Galacs/mhadb-line-sensor/mhadb-line-sensor.kicad_pcb

## KiCad design mhadb-line-sensor.kicad_pcb (2026-01-11)

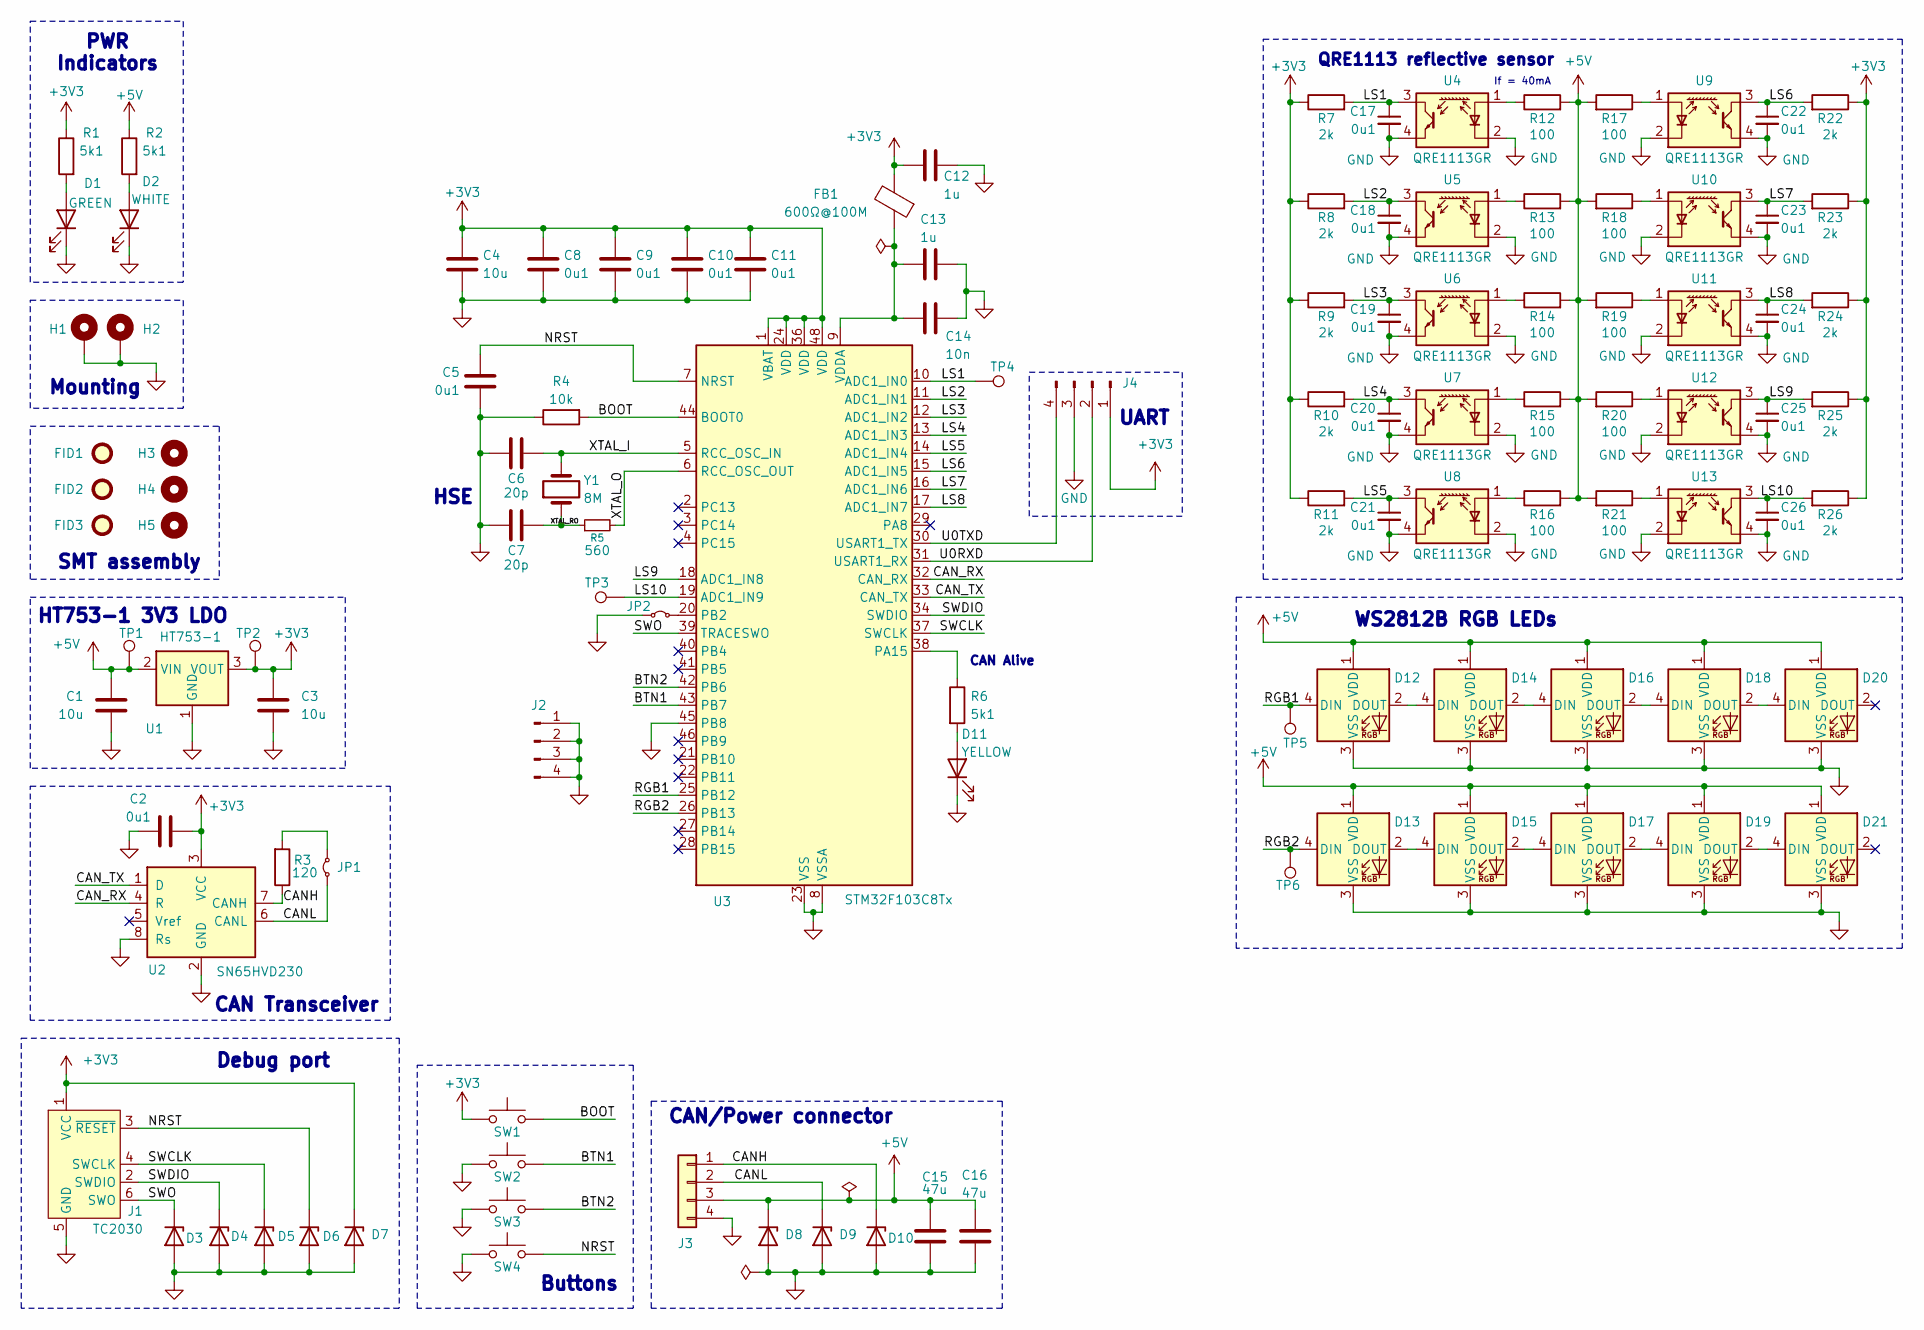
[picture p1: schematic mhadb-line-sensor.kicad_sch, MHADB Line sensor]

Parts:
C1, C3, C4: 10u; C_0805_2012Metric; Manufacturer Part Number GRM21BR61H106KE43L; JLCPCB Part # C440198
C2, C5, C8, C9, C10, C11, C17, C18, C19, C20, C21, C22, C23, C24, C25, C26: 0u1; C_0402_1005Metric; Manufacturer Part Number CL05B104KB54PNC; JLCPCB Part # C307331
C6, C7: 20p; C_0603_1608Metric; Manufacturer Part Number CL10C200JB8NNNC; JLCPCB Part # C1648
C12, C13: 1u; C_0402_1005Metric; Manufacturer Part Number CL05A105KA5NQNC; JLCPCB Part # C52923
C14: 10n; C_0402_1005Metric; Manufacturer Part Number CL05B103KB5NNNC; JLCPCB Part # C15195
C15, C16: 47u; C_1206_3216Metric; Manufacturer Part Number CL31A476MPHNNNE; JLCPCB Part # C96123
D1: GREEN; LED_0805_2012Metric; Manufacturer Part Number KT-0805G; JLCPCB Part # C2297
D2: WHITE; LED_0603_1608Metric; Manufacturer Part Number KT-0603W; JLCPCB Part # C2290
D3, D4, D5, D6, D7, D8, D9, D10: H5VU10U; Diode_DFN1006; Manufacturer Part Number H5VU10U; JLCPCB Part # C22395519
D11: YELLOW; LED_0805_2012Metric; Manufacturer Part Number KT-0805Y; JLCPCB Part # C2296
D12, D13, D14, D15, D16, D17, D18, D19, D20, D21: WS2812B; LED_WS2812B_PLCC4_5.0x5.0mm_P3.2mm; Manufacturer Part Number WS2812B-V5/W; JLCPCB Part # C2874885
FB1: 600Ω@100M; L_0805_2012Metric; Manufacturer Part Number MPZ2012S601ATD25; JLCPCB Part # C81034
FID1, FID2, FID3: Fiducial; Fiducial_1mm_Mask2mm
H1, H2: MountingHole_Pad; MountingHole_2.2mm_M2_Pad_Via
H3, H4, H5: MountingHole; ToolingHole_1.152mm
J1: TC2030; Tag-Connect_TC2030-IDC-NL_2x03_P1.27mm_Vertical
J2, J4: Conn_01x04_Pin; PinHeader_1x04_P2.54mm_Vertical
J3: Conn_01x04; JST_PH_S4B-PH-K_1x04_P2.00mm_Horizontal; Manufacturer Part Number S4B-PH-K-S(LF)(SN); JLCPCB Part # C157926
JP1: Jumper_2_Small_Bridged; SolderJumper-2_P1.3mm_Open_RoundedPad1.0x1.5mm
JP2: Jumper_2_Small_Bridged; SolderJumper-2_P1.3mm_Bridged_RoundedPad1.0x1.5mm
R1, R2, R6: 5k1; R_0402_1005Metric; Manufacturer Part Number 0402WGF5101TCE; JLCPCB Part # C25905
R3: 120; R_1206_3216Metric; Manufacturer Part Number 1206W4F1200T5E; JLCPCB Part # C17909
R4: 10k; R_0402_1005Metric; Manufacturer Part Number 0402WGF1002TCE; JLCPCB Part # C25744
R5: 560; R_0603_1608Metric; Manufacturer Part Number 0603WAF5600T5E; JLCPCB Part # C23204
R7, R8, R9, R10, R11, R22, R23, R24, R25, R26: 2k; R_0603_1608Metric; Manufacturer Part Number 0603WAF2201T5E; JLCPCB Part # C4190
R12, R13, R14, R15, R16, R17, R18, R19, R20, R21: 100; R_1206_3216Metric; Manufacturer Part Number 1206W4F1000T5E; JLCPCB Part # C17901
SW1, SW2, SW3, SW4: SW_Push; SW_SPST_TS-1088-xR020; Manufacturer Part Number TS-1088-AR02016; JLCPCB Part # C720477
TP1, TP2, TP3, TP4, TP5, TP6: TestPoint; TestPoint_Pad_D2.0mm
U1: HT753-1; SOT-89-3; Manufacturer Part Number HT7533-1; JLCPCB Part # C14289
U2: SN65HVD230; SOIC-8_3.9x4.9mm_P1.27mm; Manufacturer Part Number SN65HVD230DR; JLCPCB Part # C12084
U3: STM32F103C8Tx; LQFP-48_7x7mm_P0.5mm; Manufacturer Part Number STM32F103C8T6; JLCPCB Part # C8734
U4, U5, U6, U7, U8, U9, U10, U11, U12, U13: QRE1113GR; OnSemi_CASE100CY; Manufacturer Part Number QRE1113GR; JLCPCB Part # C232862
Y1: 8M; Crystal_SMD_5032-2Pin_5.0x3.2mm; Manufacturer Part Number X50328MSB2GI; JLCPCB Part # C115962

Connections:
+3V3: C2.1, C3.1, C4.1, C8.1, C9.1, C10.1, C11.1, C12.1, D7.1 (K), FB1.2, J1.1 (VCC), J4.1, R1.1, R7.1, R8.1, R9.1, R10.1, R11.1, R22.1, R23.1, R24.1, R25.1, R26.1, SW1.1, TP2.1, U1.3 (VOUT), U2.3 (VCC), U3.1 (VBAT), U3.24 (VDD), U3.36 (VDD), U3.48 (VDD)
+5V: C1.1, C15.1, C16.1, D8.1 (K), D12.1 (VDD), D13.1 (VDD), D14.1 (VDD), D15.1 (VDD), D16.1 (VDD), D17.1 (VDD), D18.1 (VDD), D19.1 (VDD), D20.1 (VDD), D21.1 (VDD), J3.3, R2.1, R12.2, R13.2, R14.2, R15.2, R16.2, R17.2, R18.2, R19.2, R20.2, R21.2, TP1.1, U1.2 (VIN)
/BOOT: R4.2, SW1.2, U3.44 (BOOT0)
/BTN1: SW2.2, U3.43 (PB7)
/BTN2: SW3.2, U3.42 (PB6)
/CANH: D10.1 (K), J3.1, R3.1, U2.7 (CANH)
/CANL: D9.1 (K), J3.2, JP1.1 (A), U2.6 (CANL)
/CAN_RX: U2.4 (R), U3.32 (CAN_RX)
/CAN_TX: U2.1 (D), U3.33 (CAN_TX)
/LS1: C17.1, R7.2, TP4.1, U3.10 (ADC1_IN0), U4.3
/LS2: C18.1, R8.2, U3.11 (ADC1_IN1), U5.3
/LS3: C19.1, R9.2, U3.12 (ADC1_IN2), U6.3
/LS4: C20.1, R10.2, U3.13 (ADC1_IN3), U7.3
/LS5: C21.1, R11.2, U3.14 (ADC1_IN4), U8.3
/LS6: C22.1, R22.2, U3.15 (ADC1_IN5), U9.3
/LS7: C23.1, R23.2, U3.16 (ADC1_IN6), U10.3
/LS8: C24.1, R24.2, U3.17 (ADC1_IN7), U11.3
/LS9: C25.1, R25.2, U3.18 (ADC1_IN8), U12.3
/LS10: C26.1, R26.2, TP3.1, U3.19 (ADC1_IN9), U13.3
/NRST: C5.1, D6.1 (K), J1.3 (~RESET), SW4.2, U3.7 (NRST)
/RGB1: D12.4 (DIN), TP5.1, U3.25 (PB12)
/RGB2: D13.4 (DIN), TP6.1, U3.26 (PB13)
/SWCLK: D5.1 (K), J1.4 (SWCLK), U3.37 (SWCLK)
/SWDIO: D4.1 (K), J1.2 (SWDIO), U3.34 (SWDIO)
/SWO: D3.1 (K), J1.6 (SWO), U3.39 (TRACESWO)
/U0RXD: J4.2, U3.31 (USART1_RX)
/U0TXD: J4.4, U3.30 (USART1_TX)
/XTAL_I: C6.1, U3.5 (RCC_OSC_IN), Y1.2
/XTAL_O: R5.2, U3.6 (RCC_OSC_OUT)
/XTAL_RO: C7.1, R5.1, Y1.1
GND: C1.2, C2.2, C3.2, C4.2, C5.2, C6.2, C7.2, C8.2, C9.2, C10.2, C11.2, C12.2, C13.2, C14.2, C15.2, C16.2, C17.2, C18.2, C19.2, C20.2, C21.2, C22.2, C23.2, C24.2, C25.2, C26.2, D1.1 (K), D2.1 (K), D3.2 (A), D4.2 (A), D5.2 (A), D6.2 (A), D7.2 (A), D8.2 (A), D9.2 (A), D10.2 (A), D11.1 (K), D12.3 (VSS), D13.3 (VSS), D14.3 (VSS), D15.3 (VSS), D16.3 (VSS), D17.3 (VSS), D18.3 (VSS), D19.3 (VSS), D20.3 (VSS), D21.3 (VSS), H1.1, H2.1, J1.5 (GND), J2.1, J2.2, J2.3, J2.4, J3.4, J4.3, JP2.1 (A), R4.1, SW2.1, SW3.1, SW4.1, U1.1 (GND), U2.2 (GND), U2.8 (Rs), U3.8 (VSSA), U3.23 (VSS), U3.35 (VSS), U3.45 (PB8), U3.47 (VSS), U4.2 (K), U4.4, U5.2 (K), U5.4, U6.2 (K), U6.4, U7.2 (K), U7.4, U8.2 (K), U8.4, U9.2 (K), U9.4, U10.2 (K), U10.4, U11.2 (K), U11.4, U12.2 (K), U12.4, U13.2 (K), U13.4
unnamed: D1.2 (A), R1.2
unnamed: D2.2 (A), R2.2
unnamed: D11.2 (A), R6.2
unnamed: D12.2 (DOUT), D14.4 (DIN)
unnamed: D13.2 (DOUT), D15.4 (DIN)
unnamed: D14.2 (DOUT), D16.4 (DIN)
unnamed: D15.2 (DOUT), D17.4 (DIN)
unnamed: D16.2 (DOUT), D18.4 (DIN)
unnamed: D17.2 (DOUT), D19.4 (DIN)
unnamed: D18.2 (DOUT), D20.4 (DIN)
unnamed: D19.2 (DOUT), D21.4 (DIN)
unnamed: JP1.2 (B), R3.2
unnamed: JP2.2 (B), U3.20 (PB2)
unnamed: R6.1, U3.38 (PA15)
unnamed: C13.1, C14.1, FB1.1, U3.9 (VDDA)
unnamed: R12.1, U4.1 (A)
unnamed: R13.1, U5.1 (A)
unnamed: R14.1, U6.1 (A)
unnamed: R15.1, U7.1 (A)
unnamed: R16.1, U8.1 (A)
unnamed: R17.1, U9.1 (A)
unnamed: R18.1, U10.1 (A)
unnamed: R19.1, U11.1 (A)
unnamed: R20.1, U12.1 (A)
unnamed: R21.1, U13.1 (A)

Notes on the sheet:
CAN Transceiver
WS2812B RGB LEDs
Buttons
CAN Alive
If = 40mA
UART
PWR Indicators
SMT assembly
QRE1113 reflective sensor
Mounting
HT753-1 3V3 LDO
Debug port
CAN/Power connector
HSE

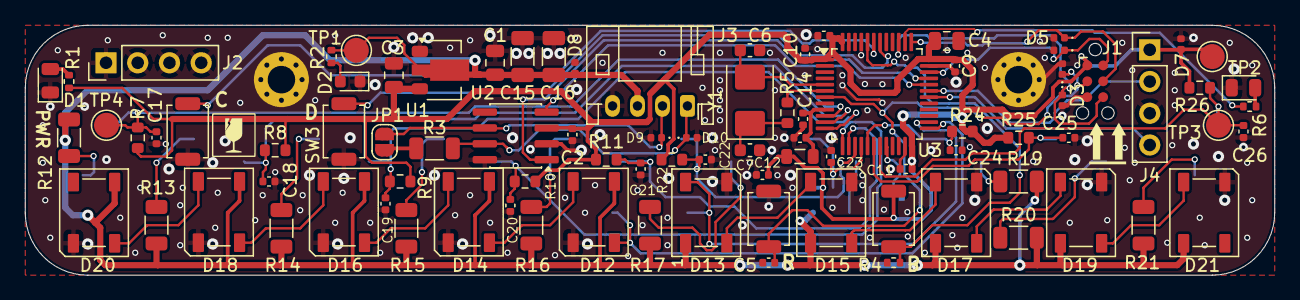
[picture p2: board mhadb-line-sensor.kicad_pcb from above]

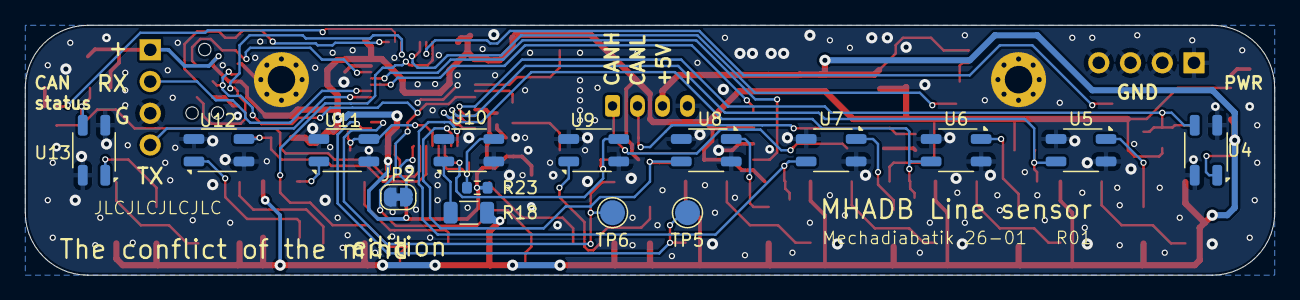
[picture p3: board mhadb-line-sensor.kicad_pcb from below]

Board: 2 copper layers, 100.0 x 20.0 mm, 106 parts (15 on the bottom side), 56 nets.
