Galacs/mhadb-line-sensor/(commit log)

2026-01-08 schem: add STM32F103C8Tx MCU with decoupling
    [mhadb-line-sensor.kicad_pcb, mhadb-line-sensor.kicad_sch]
2026-01-08 schem: import HSE and boot/rst
    [mhadb-line-sensor.kicad_sch]
2026-01-08 schem: add CAN/Power connector
    [mhadb-line-sensor.kicad_sch]
2026-01-08 schem: add TC2030 SWD debug port
    [mhadb-line-sensor.kicad_sch]
2026-01-08 schem: add SN65HVD230 CAN transceiver
    [mhadb-line-sensor.kicad_sch]
2026-01-08 schem: add UART1 header
    [mhadb-line-sensor.kicad_sch]
2026-01-08 schem: add 10x QRE1113 reflective sensor
    [mhadb-line-sensor.kicad_sch]
2026-01-08 schem: add 10x WS2812B RGB LEDs
    [mhadb-line-sensor.kicad_sch]
2026-01-09 schem: add BOOT and RST btns
    [mhadb-line-sensor.kicad_sch]
2026-01-09 schem: add 3v3 input bulk capacitance
    [mhadb-line-sensor.kicad_sch]
2026-01-09 schem: add indicator leds
    [mhadb-line-sensor.kicad_sch]
2026-01-09 schem: add general btns
    [mhadb-line-sensor.kicad_sch]
2026-01-09 schem: connect RGB leds to MCU
    [mhadb-line-sensor.kicad_sch]
2026-01-09 schem: add spare GPIOs
    [mhadb-line-sensor.kicad_sch]
2026-01-09 schem: switch to 5v architecture and add 3v3 LDO
    [mhadb-line-sensor.kicad_sch]
2026-01-09 schem: add no connects
    [mhadb-line-sensor.kicad_sch]
2026-01-09 schem: add test points
    [mhadb-line-sensor.kicad_sch]
2026-01-09 schem: run and fix ERC
    [mhadb-line-sensor.kicad_sch]
2026-01-09 schem: add assembly and mounting holes
    [mhadb-line-sensor.kicad_sch]
2026-01-09 schem: add net classes
    [mhadb-line-sensor.kicad_sch]
2026-01-09 schem: add missing footprints and ordering info
    [mhadb-line-sensor.kicad_sch]
2026-01-09 schem: add title
    [mhadb-line-sensor.kicad_sch]
2026-01-09 schem: renumber
    [mhadb-line-sensor.kicad_sch]
2026-01-09 pcb: create file and import stackup and constraints
    [mhadb-line-sensor.kicad_pcb]
2026-01-09 pcb: import footprints from schema
    [mhadb-line-sensor.kicad_pcb]
2026-01-09 schem/pcb: add EM stop btn
    [mhadb-line-sensor.kicad_pcb, mhadb-line-sensor.kicad_sch]
2026-01-09 pcb: add board outline
    [mhadb-line-sensor.kicad_pcb]
2026-01-09 pcb: initial sensor placement
    [mhadb-line-sensor.kicad_pcb]
2026-01-09 pcb: initial rough layout
    [mhadb-line-sensor.kicad_pcb, mhadb-line-sensor.kicad_sch]
2026-01-09 pcb: add gnd planes
    [mhadb-line-sensor.kicad_pcb]
2026-01-09 pcb: add gnd vias
    [mhadb-line-sensor.kicad_pcb]
2026-01-09 pcb: add SWD routing
    [mhadb-line-sensor.kicad_pcb]
2026-01-09 pcb: add CAN routing
    [mhadb-line-sensor.kicad_pcb]
2026-01-09 pcb: add UART routing
    [mhadb-line-sensor.kicad_pcb]
2026-01-09 pcb: add QRE1113 collectors routing
    [mhadb-line-sensor.kicad_pcb]
2026-01-09 pcb: add RGB leds routing
    [mhadb-line-sensor.kicad_pcb]
2026-01-10 schem/pcb: add BOOT1 strapping
    [mhadb-line-sensor.kicad_pcb, mhadb-line-sensor.kicad_sch]
2026-01-10 pcb: add QRE1113 emitters routing
    [mhadb-line-sensor.kicad_pcb]
2026-01-10 pcb: add 3v3 routing
    [mhadb-line-sensor.kicad_pcb]
2026-01-10 pcb: add 5v routing
    [mhadb-line-sensor.kicad_pcb]
2026-01-10 pcb: add BOOT and RST routing
    [mhadb-line-sensor.kicad_pcb]
2026-01-10 pcb: add tag connect RST and CAN status led routing
    [mhadb-line-sensor.kicad_pcb]
2026-01-10 pcb: add btns routing
    [mhadb-line-sensor.kicad_pcb]
2026-01-10 schem/pcb: remove spare GPIOs
    [mhadb-line-sensor.kicad_pcb, mhadb-line-sensor.kicad_sch]
2026-01-10 pcb: add stitching vias
    [mhadb-line-sensor.kicad_pcb, mhadb-line-sensor.kicad_sch]
2026-01-10 pcb: run and fix DRC
    [mhadb-line-sensor.kicad_pcb]
2026-01-10 pcb(silkscreen): clean reference designators
    [mhadb-line-sensor.kicad_pcb, mhadb-line-sensor.kicad_sch]
2026-01-10 pcb: add title
    [mhadb-line-sensor.kicad_pcb]
2026-01-10 pcb(silkscreen): add user txt
    [mhadb-line-sensor.kicad_pcb]
2026-01-10 pcb(silkscreen): replace 何何何何 placeholder
    [mhadb-line-sensor.kicad_pcb, mhadb-line-sensor.kicad_sch]
2026-01-10 add production files
    [bom.csv, designators.csv, mhadb-line-sensor.kicad_pcb, positions.csv]
2026-01-11 pcb(silkscreen): add icons
    [mhadb-line-sensor.kicad_pcb]
2026-01-11 regenerate production files
    [designators.csv]
2026-01-11 update BOM
    [mhadb-line-sensor.kicad_pcb, mhadb-line-sensor.kicad_sch]
